tfeldmann/Mecanum-Robot/README.md

# Mecanum-Robot
Firmware and Simulator for controlling a vehicle with mecanum wheels.
