tfeldmann/Mecanum-Robot/Documentation/Projektstudie/Projektstudie.tex

\input{Einstellungen}

\titlehead{
    \begin{tabular}{l  p{9cm} c}
        & &   \\
       & & \textbf{ Fachbereich Maschinenbau }\\
        
    \end{tabular}
   % Westfälische Hochschule\\Fachbereich Maschinenbau 
    \vspace{1.5cm}}

\subject{Projektstudie Robotics \& Automation}

\title{Entwicklung und Inbetriebnahme einer mikrocontroller-gestützten Ansteuerung eines Roboters mit omnidirektionalem Antrieb\vspace{1.5cm}}

\subtitle{Development and implementation of a microcontroller-based control-system for a omnidirectional robotic vehicle.\vspace{1.5cm}}

\author{
    \begin{tabular}{rl}
        Manuel Fehmer & 200923513 \\
        Thomas Feldmann & 200923381 \\
        Marlene Feldmann & 200825051 \\
        Carsten Hußmann & 200824460\\
    \end{tabular}\vspace{0.3cm}}

\begin{document}
\begin{titlepage}
\maketitle
\pagenumbering{gobble}
\end{titlepage}
\tableofcontents
\pagenumbering{arabic}
\newpage
\include{Einleitung}
\include{Mathematik}
\include{Hardware}
\include{Treiber}
\include{API}
\include{Steuerung}
\include{Fazit}
\include{Ausblick}
\end{document}
