tfeldmann/Mecanum-Robot/Documentation/Projektstudie/Fazit.tex

% !TEX root = Projektstudie.tex
% Fazit

\section{Fazit}
\label{sec:Fazit}

Während der Versuchsfahrten stellt sich heraus, dass eine genaue Positionierung nicht allein über die Kenntnis der Radgeschwindigkeiten möglich ist.
Kleinste Unebenheiten oder Verschmutzungen resultieren in durchrutschenden oder abhebenden Rädern und somit in starken Fahrbahnabweichungen.
Für den produktiven Betrieb sind daher externe Positionsreferenzen zwingend notwendig (siehe Kapitel~\ref{sec:Ausblick}).

Neben dem Fahrbahnuntergrund erschweren mechanische Probleme ein reibungsloses Fahren des Mecanum-Roboters:

\begin{itemize}
    \item{Die Motoren sind zu schwach dimensioniert und verlieren bei abrupten Manövern Schritte}
    \item{Das treibende Rad des Riementriebs löst sich nach längerem Gebrauch von der Welle und muss mit gezielten Hammerschlägen wieder an seine Position gebracht werden. Dies hat zur Folge, dass die Mecanum-Räder zu nah am Riementrieb liegen und sich regelmäßig mit den überstehenden Schrauben im Riemen verhaken.}
\end{itemize}

Ein Beheben dieser Probleme setzt eine Neukonstruktion der betrachteten Komponenten voraus. Weitere notwendige Änderungen werden neben Optimierungsansätzen und möglichen folgenden Projekten im Ausblick Kapitel~\ref{sec:Ausblick} beschrieben.
