tfeldmann/Mecanum-Robot/Documentation/Kreisfahrt/Abbildungen/Viertelkreis-seitwaerts.pdf

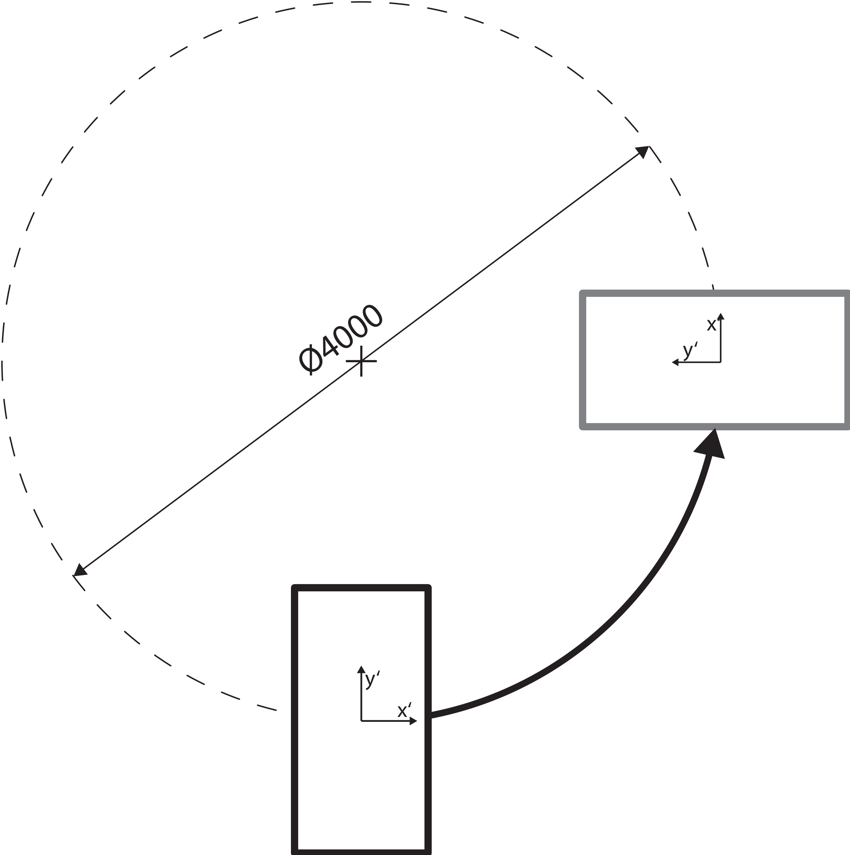
[picture p6: figure]

x

y
