tfeldmann/Mecanum-Robot/Documentation/Kreisfahrt/Abbildungen/Viertelkreis-translatorisch.pdf

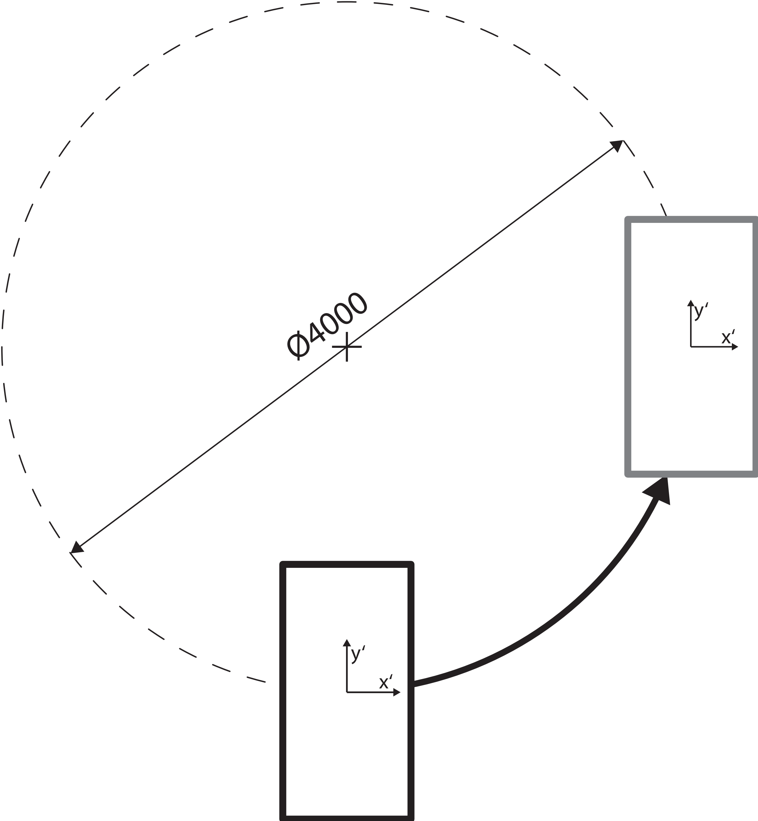
[picture p7: figure]

x

y
