tfeldmann/Mecanum-Robot/Documentation/Kreisfahrt/Abbildungen/Viertelkreis-vorwaerts.pdf

x

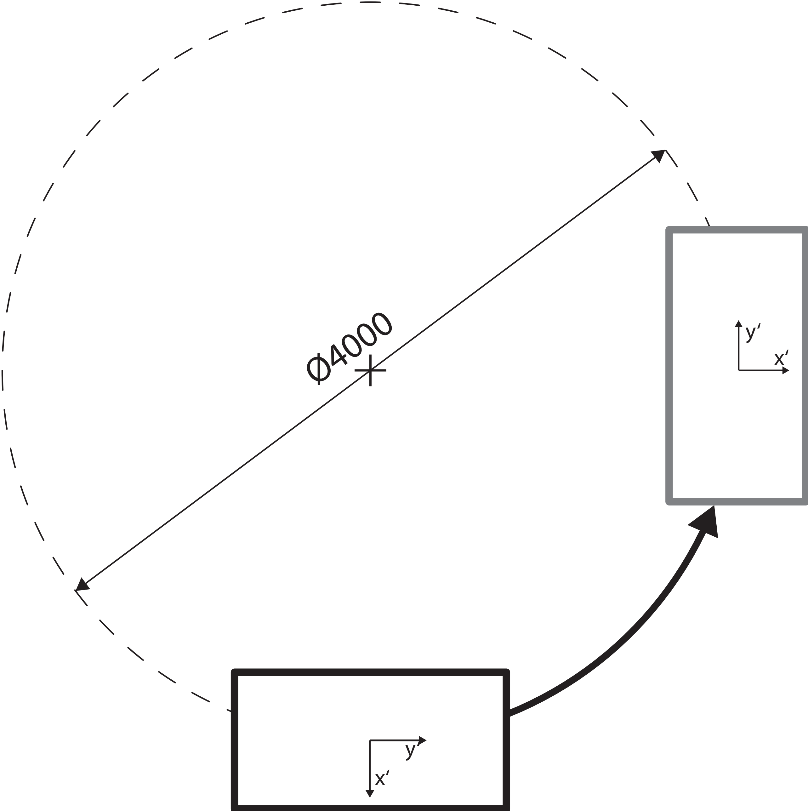
[picture p8: figure]

y
