tfeldmann/Mecanum-Robot/Documentation/Projektstudie/Abbildungen/Himmelsrichtungen.pdf

N

NW | NO

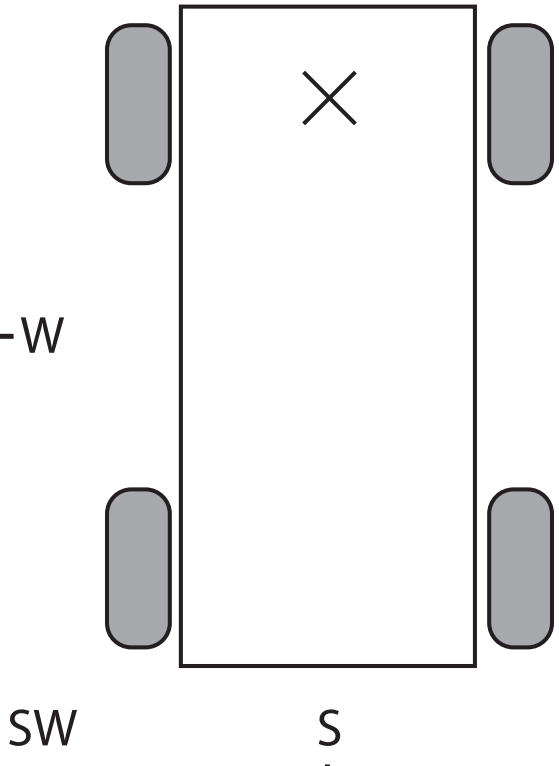
[picture p9: figure]

O

SO
