tfeldmann/Mecanum-Robot/Documentation/Projektstudie/Abbildungen/Joystick.pdf

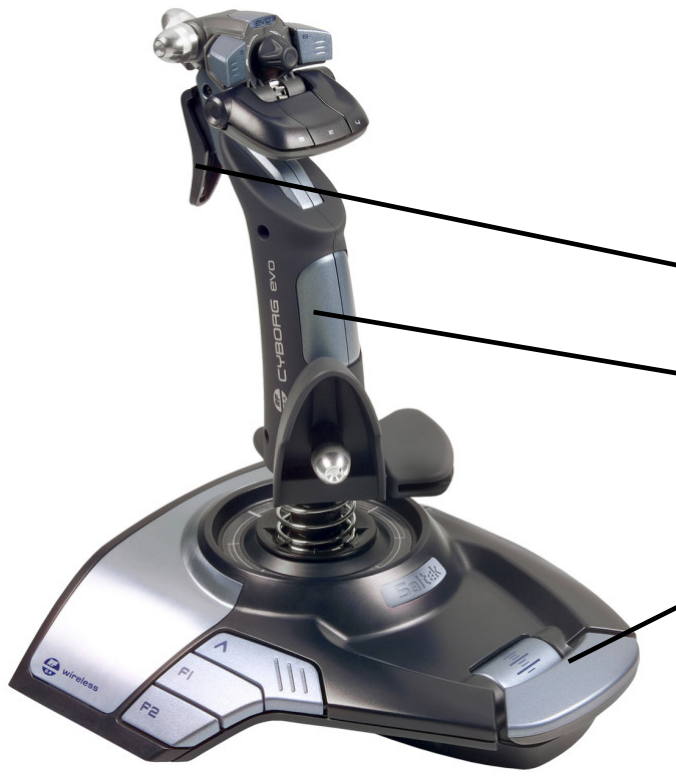
[picture p10: figure]

Maximalgeschwindigkeit

Rotation, Translation

Start / Stopp
