tfeldmann/Mecanum-Robot/Documentation/Kreisfahrt/Abbildungen/Koordinaten.pdf

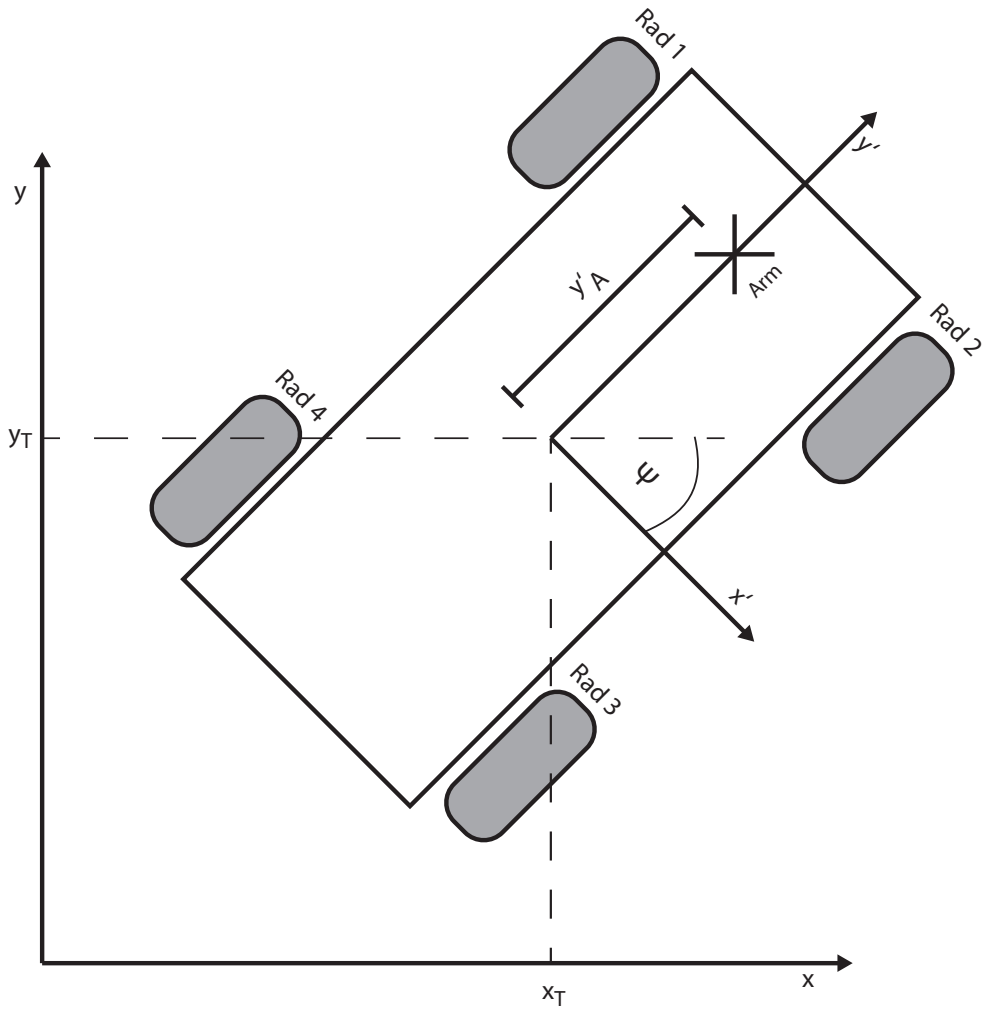
[picture p11: page 1]
Rad 1; Rad 2; Rad 3; Rad 4; Arm
