tfeldmann/Mecanum-Robot/Documentation/Projektstudie/Abbildungen/Verbindungen.pdf

# Roboter

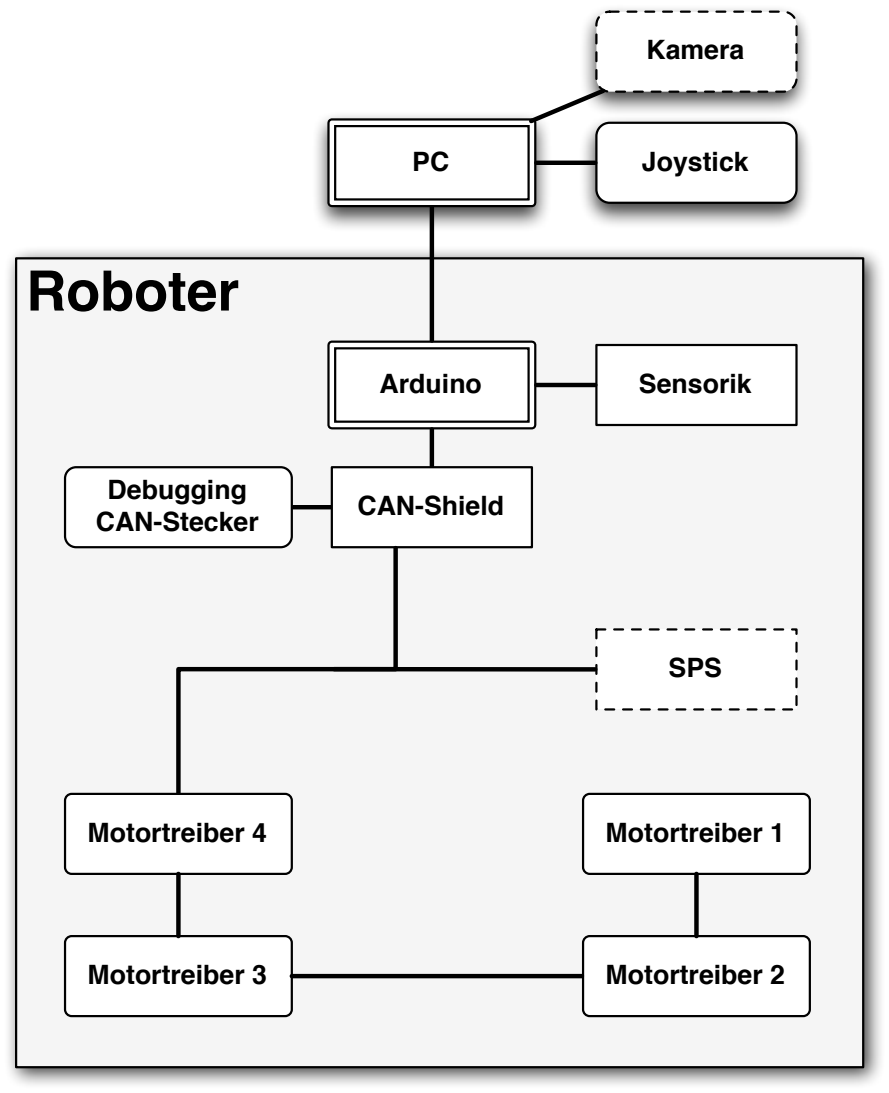
[picture p12: page 1]
Arduino; SPS; Motortreiber 4; Motortreiber 1; Motortreiber 3; Motortreiber 2; Joystick; Kamera; Sensorik

CAN-Shield Debugging
CAN-Stecker
