tfeldmann/Mecanum-Robot/Documentation/Projektstudie/Abbildungen/CAN-Shield-Layout-Bottom.pdf

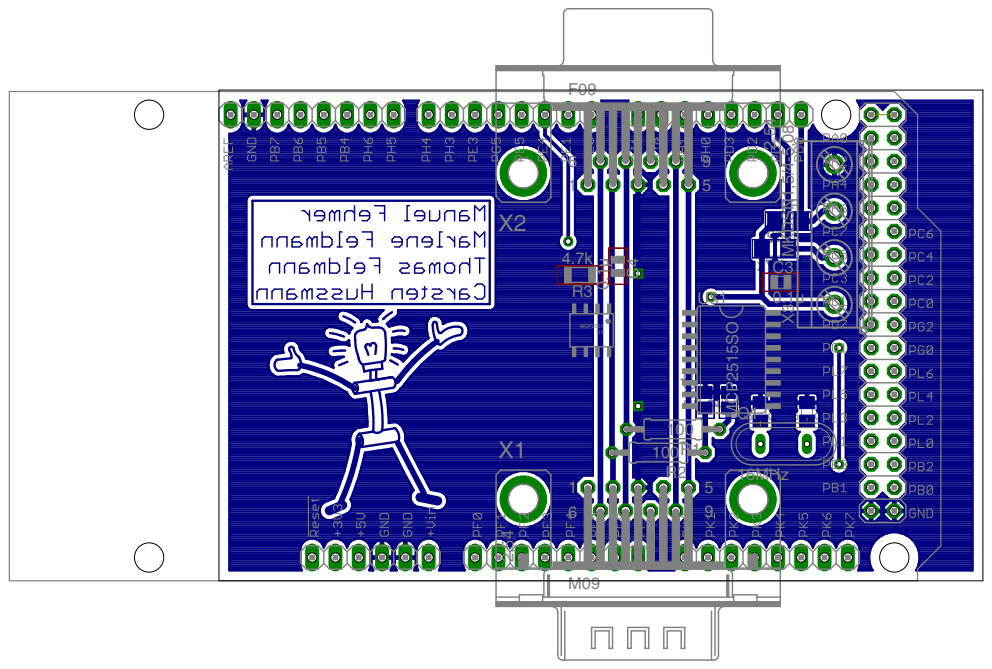
[picture p13: page 1]
