tfeldmann/Mecanum-Robot/Documentation/Projektstudie/Abbildungen/CAN-Shield-Layout-Top.pdf

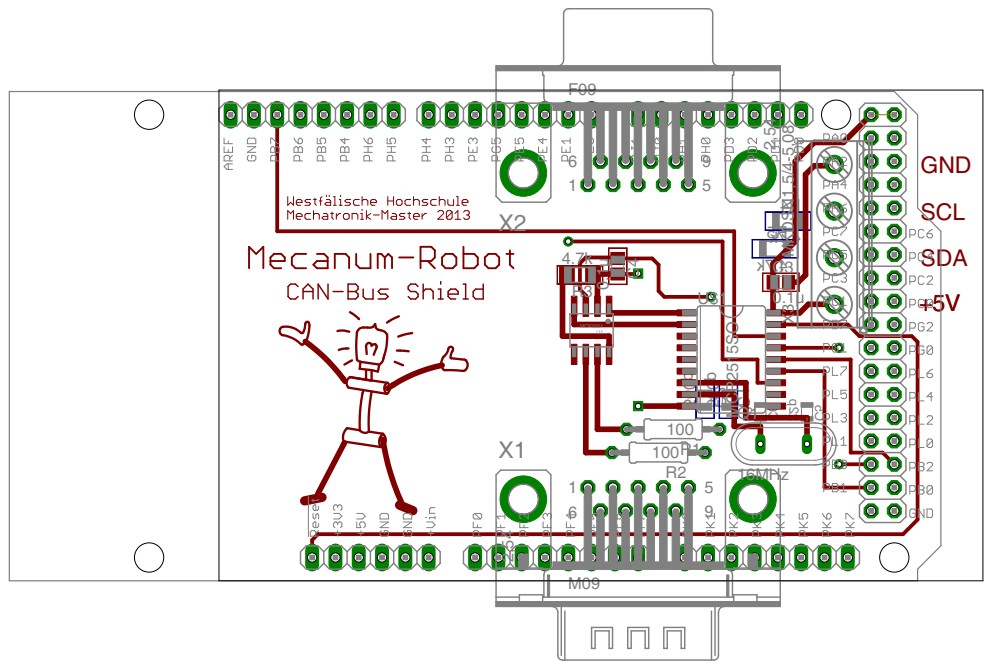
[picture p14: page 1]
