tfeldmann/Mecanum-Robot/Documentation/Projektstudie/Abbildungen/CAN-Shield-Layout.pdf

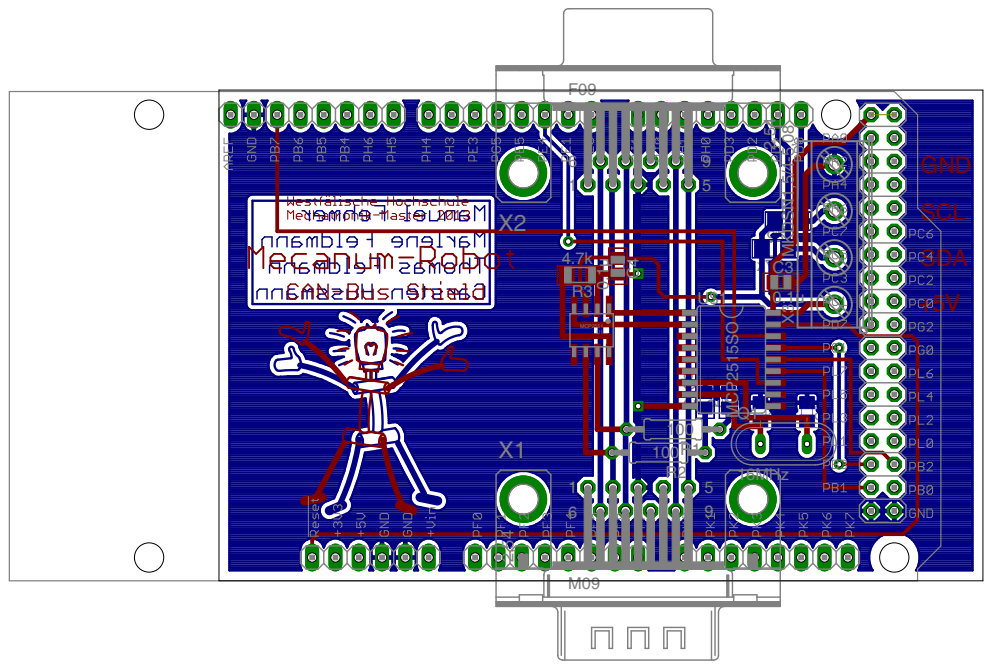
[picture p15: page 1]
