tfeldmann/Mecanum-Robot/Documentation/Projektstudie/Abbildungen/Drehrichtung.pdf

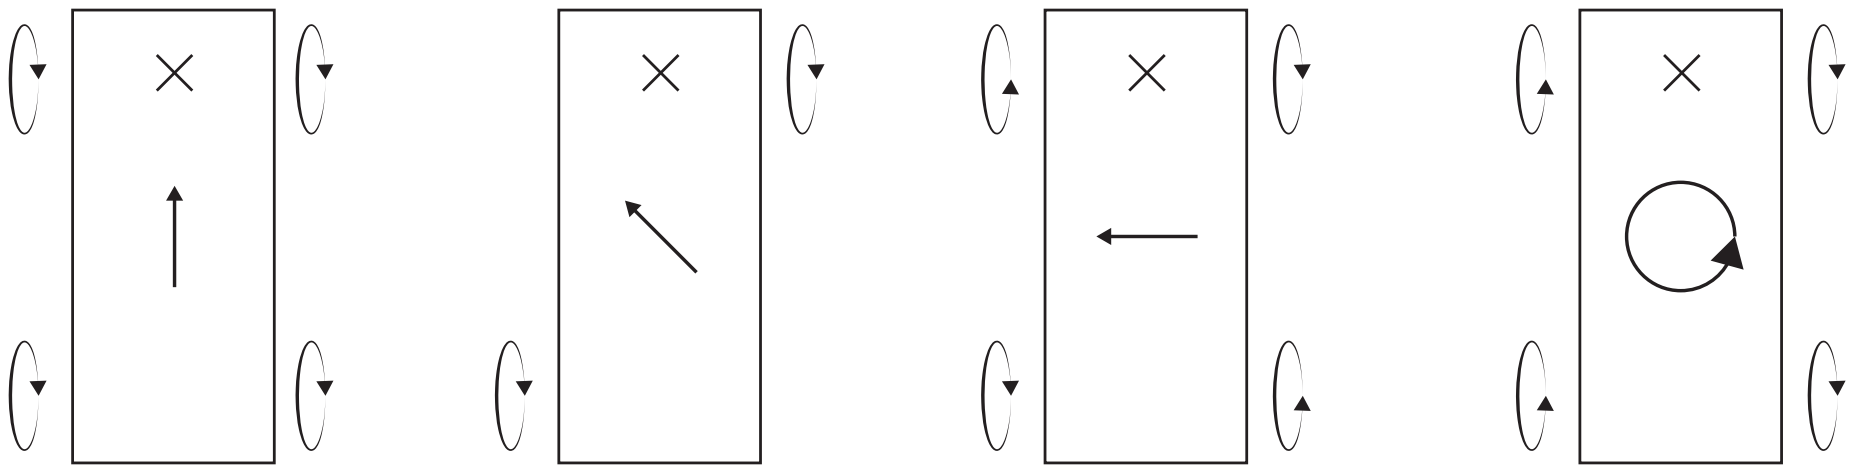
[picture p16: page 1]
