tfeldmann/Mecanum-Robot/Firmware/Api.ino

//
// Api.ino
//

#include <SerialCommand.h>

SerialCommand serialCommand;

void api_update()
{
    serialCommand.readSerial();
}

void api_unknown(const char *command)
{
    Serial.print("!E02: Unknown command: ");
    Serial.println(command);

    // stop robot for safety
    api_stop();
}

void api_begin()
{
    serialCommand.addCommand("@start", api_start);
    serialCommand.addCommand("@stop", api_stop);
    serialCommand.addCommand("@v", api_v);
    serialCommand.addCommand("@demo_translation", demo_translation);
    serialCommand.addCommand("@demo_forward", demo_forward);
    serialCommand.addCommand("@demo_sideways", demo_sideways);
    serialCommand.addCommand("@demo_stopWithDelay", demo_stopWithDelay);
    serialCommand.addCommand("@about", api_about);
    serialCommand.setDefaultHandler(api_unknown);
}


// ============================================================================
// custom functions:

/**
 * Start the engines
 * Usage: "@start"
 */
void api_start()
{
    robot_startMotors();
}

/**
 * Perform a quick stop
 * Usage: "@stop"
 */
void api_stop()
{
    demo_stop();
    robot_quickStop();
}

/**
 * Set the desired velocity for each robot wheel.
 *
 * Usage: "@v [wheel 1] [wheel 2] [wheel 3] [wheel 4]"
 * Range: -25000...25000
 * Unit:  steps/second
 */
void api_v()
{
    int v[4] = {0, 0, 0, 0};
    for (int wheel = 0; wheel < 4; wheel++)
    {
        char *value = serialCommand.next();
        if (value == NULL)
        {
            Serial.println("!E01: Not enough arguments supplied.");
            return;
        }
        v[wheel] = atoi(value);
    }
    robot_setMotorSpeed(v);
}

void api_about()
{
    Serial.print("#Firmware Version: ");
    Serial.println(VERSION);
    Serial.print("#Compiled on: ");
    Serial.println(__TIMESTAMP__);
}
