tfeldmann/Mecanum-Robot/(commit log)

2013-05-08 Added Can_bus_shield library
2013-05-21 start and stop with joystick button
2013-05-28 renamed motorStart to motorVelocitySettings
2013-05-28 restructured demo to use function pointers to the currently selected demo
2013-05-30 Der Abstand der Kreisfahrt-Bilder etwas verringert.
2013-05-30 Formatierung und Einfügen einer TODO-Liste
2013-05-30 Foto des Roboters eingefügt
2013-06-01 Labels für die Kreisfahrtbilder
2013-06-01 Genaueres zur Implementierung der Fahrten
2013-06-03 Formulierung in der Einleitung
2013-06-03 Formatierung der Aufgabenstellung
2013-06-04 deleted SPI folder
2013-06-04 Syntax Highlighting für die Roboterapi eingerichtet
2013-06-04 Liste der Befehle eingefügt
2013-06-04 Ereignisse und Aktivitäten hinzugefügt
2013-06-05 Beginn der C-API Beschreibung
2013-06-07 Ausblick subsections für Deckenkamera, Hindernisse umfahren und Steuerung via Netzwerk hinzugefügt
2013-06-09 reset demo_stopWithDelay to match description
    [Demo.ino]
2013-06-09 Bild des Joysticks hinzugefügt
2013-06-10 Bild der Visualisierung eingefügt
2013-06-10 Visualisierung der Beschreibung angepasst
2013-06-10 Bild der Visualisierung in den Text eingefügt
2013-06-10 Ausblick: Dijkstra und Funknetzwerk
2013-06-10 Korrektur der Drehrichtungen
2013-06-10 Formatierung und kleine Verbesserungen bei Mathe
2013-06-10 Formatierung und Textänderungen am Hardwarekapitel
